eSpark-Consulting-Group/issamsmaali-powerbackupcircuit/Design-Files/PowerBackup-v2.1.1/Delievrables/Rendering/Isometric-02.png

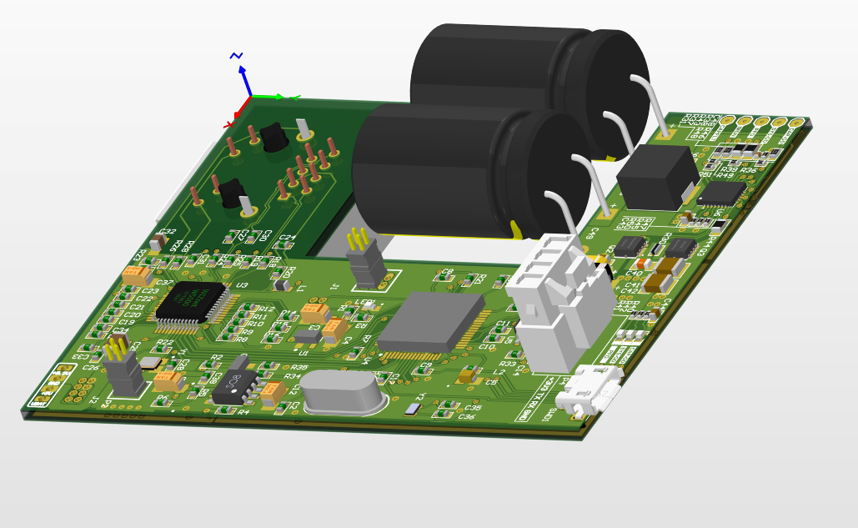
Design-Files/PowerBackup-v2.1.1/Delievrables/Rendering/Isometric-02.png
