eSpark-Consulting-Group/issamsmaali-powerbackupcircuit/Design-Files/PowerBackup-v2.1.1/Delievrables/Rendering/2D-View.png

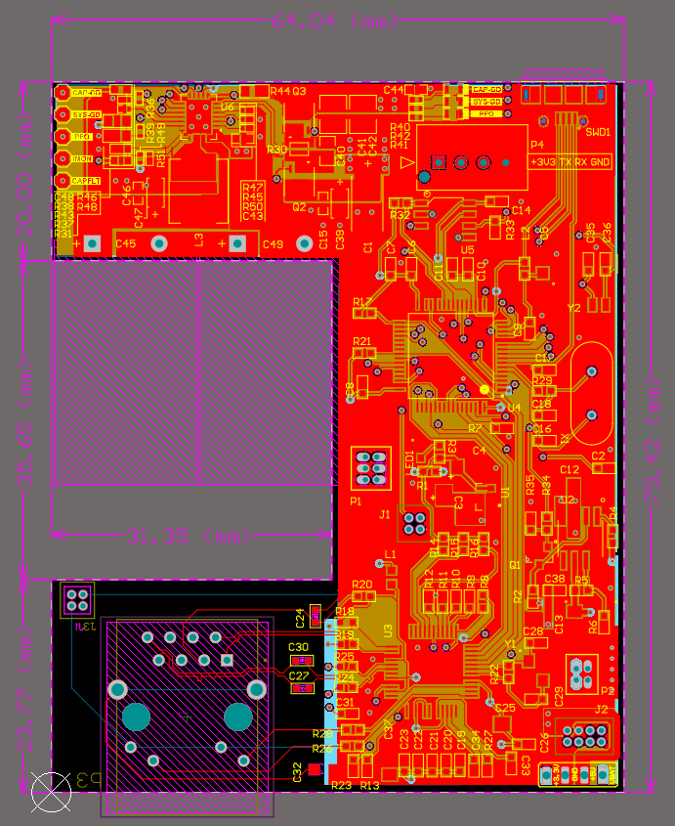
Design-Files/PowerBackup-v2.1.1/Delievrables/Rendering/2D-View.png
