eSpark-Consulting-Group/issamsmaali-powerbackupcircuit/Design-Files/PowerBackup-v2.1.1/Delievrables/Rendering/Isometric.png

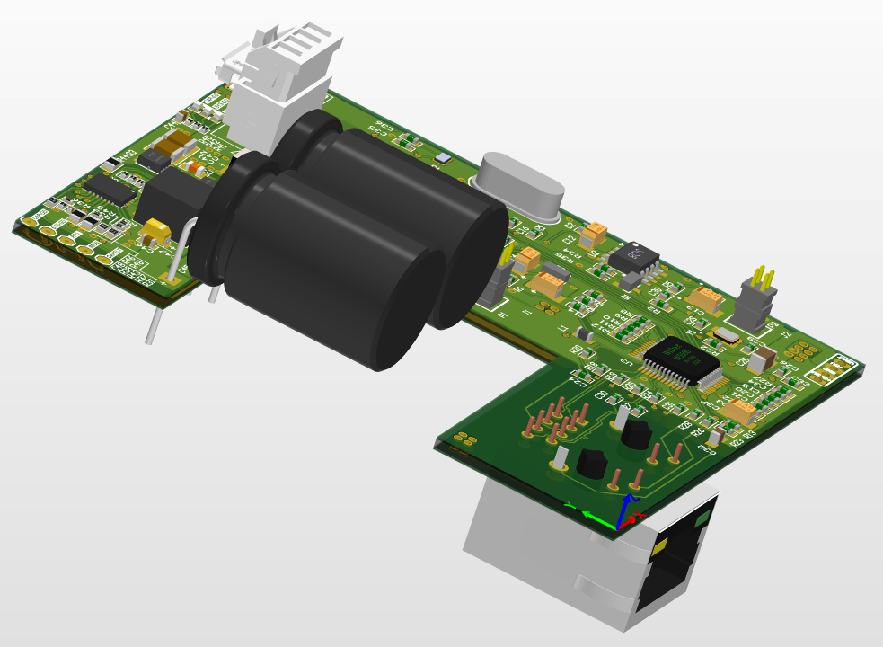
Design-Files/PowerBackup-v2.1.1/Delievrables/Rendering/Isometric.png
