eSpark-Consulting-Group/issamsmaali-powerbackupcircuit/Design-Files/PowerBackup-v2.1.1/BOM/Client_BOM.xlsx

# | Item Type | Designator | Description | Footprint | Manufacturer Part Number | Manufacturer | Comment | Quantity | Remarks
1 | Capacitors | C1 | CAP ALUM POLY 68UF 20% 50V SMD | 50SVPF68M | 50SVPF68M | Panasonic | 68uF | 1
2 | Capacitors | C2, C6, C7, C8, C9, C11, C14, C17, C19, C20, C21, C22, C23, C24 | CAPACITOR 0603 CERAMIC | 0603C-TBD | CL10F104ZO8NNNC | Samsung | 0.1uF/16V | 14
3 | Capacitors | C3, C4 | CAP TANT 10UF 10% 10V 1206 (3216) | C-3216(TANTAL) - INV | TAJA106K006RNJ | Kyocera AVX | 10uF/10V | 2
4 | Capacitors | C5 | Polarized Capacitor 1uF/16V TANTAL 0805 | C-2012 - TANT | F921C105MPA | Kyocera AVX | 1uF/6.3v | 1
5 | Capacitors | C10, C38 | Capacitor 1uF 6.3V X5R 10% SMD 0603 | 0603C-TBD | CL10A105KQ8NNNC | Samsung | 1uF/6.3v | 2
6 | Capacitors | C12, C13 | Tantalum Capacitors - Solid SMD 10V 22uF 20% 3216 -1206 | C-3216(TANTAL) | TAJA226M010RNJ | Kyocera AVX | 22uF/10V | 2
7 | Capacitors | C15, C43, C44, C46 | Multilayer Ceramic Capacitor, 0.1 uF, 16 V, -20, +80%, Y5V, 0603 [1608 Metric] | Cap-0603 | CL10F104ZO8NNNC | Samsung | 0.1uF | 4
8 | Capacitors | C16, C18 | Capacitor 20p 50v 0603 | 0603C-TBD | CL10C200JB8NNNC | Samsung | 20pF | 2
9 | Capacitors | C25, C37 | CAP TANT 10UF 10% 10V 1206 (3216) | C-3216(TANTAL) | TAJA106K010RNJ | Kyocera AVX | 10uF/10V | 2
10 | Capacitors | C26, C31, C34 | Multilayer Ceramic Capacitors MLCC - SMD/SMT 16V 0.01uF 0603 X8R 5% | C-1608 | C0603X103J4HACTU | KEMET | 10nF | 3
11 | Capacitors | C27, C30 | 6800pF ±10% 200V Ceramic Capacitor X7R 0603 (1608 Metric) | C-1608 | C0603C682K2RECAUTO | KEMET | 6.8.nF | 2
12 | Capacitors | C28, C29 | 18pF ±5% 50V Ceramic Capacitor C0G, NP0 0603 (1608 Metric) | C-1608 | CL10C180JB8NNNC | Samsung | 18pF | 2
13 | Capacitors | C32 | 1000pF ±10% 1000V (1kV) Ceramic Capacitor X7R 0805 (2012 Metric) | C-2012 | C0805C102KDRACAUTO | KEMET | 1nF/2kV | 1
14 | Capacitors | C33 | CAP CER 4,7UF 10V X5R 0603 | 0603C-TBD |  |  | 4.7uF | 1
15 | Capacitors | C35, C36 | CAPACITOR 0603 CERAMIC 9p 50V | 0603C-TBD | CGA3E2NP01H090D080AA | TDK | 9p | 2
16 | Capacitors | C39, C47 | CAP TANT 10UF 10% 10V 1206 | Case-A | TAJA106K010RNJ | Kyocera AVX | 10uF | 2
17 | Capacitors | C40 | CAP CER 2.2UF 16V X7R 0805 | Cap-0805 | EMK212B7225KGHT | Taiyo Yuden | 2.2uF | 1
18 | Capacitors | C41, C42 | CAP CER 100UF 16V X5R 1210 | Cap-1210 | EMK325ABJ107MM-P | Taiyo Yuden | 100uF | 2
19 | Capacitors | C45, C49 | CAPACITOR 25F -10%, +30% 2.7V TH | DGH256Q2R7 | DGH256Q2R7 | CDE Illinois Capacitor | 25F | 2
20 | Capacitors | C48 | CAP CER 1000PF 25V X7R 0402 | Cap-0402 | CC0402KRX7R8BB102 | Yageo | 1nF | 1
21 | Header | J1, J3 | Socket Strip, Cuttable, Double Row, 0.050"x0.050" Pitch | SFMC-102-X1-XX-D | SFMC-102-X1-XX-D | SAMTEC | - | 2
22 | Header | J2 | Socket Strip, Cuttable, Double Row, 0.050"x0.050" Pitch | SFMC-104-X1-XX-D | SFMC-104-X1-XX-D | SAMTEC | - | 1
23 | Inductor | L1 | FIXED IND 1.5UH 625MA 150 MOHM | L-1608 | GLFR1608T1R5M-LR | TDK | - | 1
24 | Inductor | L2 | FERRITE BEAD 30 OHM 0603 1LN | 0603C-TBD | MPZ1608S300ATAH0 | TDK | 30 OHM | 1
25 | Inductor | L3 | 9.5A 2.2uH ±20% 16A SMD,7.15x6.6x5mm Power Inductors ROHS | MS0650-2R2M-C | MS0650-2R2M-C | COILMX | 2.2uH | 1
26 | Inductor | LED1 | LED RED CLEAR 2SMD 1.95V, 5mA | LED-1608 | 19-217/R6C-AL1M2VY/3T | Everlight | POWER | 1
27 | LED | LED2, LED3 | yellow 0603 Light Emitting Diodes (LED) ROHS | LED-0603 | NCD0603Y2 | Foshan NationStar Optoelectronics | Yellow | 2
28 | LED | LED4 | RED LED 0603 Light Emitting Diodes | LED-0603 | NCD0603R3 | Foshan NationStar Optoelectronics | RED | 1
29 | Header | P1 | CONN HDR 6POS 0.05 STACK T/H Dual row | 3x2A 1.27 Double Samtec | FW-03-04-L-D-200-100 | Samtec | - | 1
30 | Header | P2 | CONN HDR 4POS 0.05 STACK T/H Dual row | 2x2A 1.27 Double Samtec | FW-02-04-L-D-200-100 | Samtec | - | 1
31 | Header | P3 | CONN MAGJACK 1PORT 100 BASE-T | WIZnet_RB1-125BAG1A_0 | RB1-125BAG1A | WIZnet | - | 1
32 | Header | P4 | Connector Header Through Hole 4 position 0.098" (2.50mm) | CON_2078430004_MOL | 207843-0004 | Molex | - | 1
33 | MOSFETs | Q1 | MOSFET N-CH 60V 115MA SOT23-3 | SOT23 |  |  | - | 1
34 | MOSFETs | Q2, Q3 | MOSFET N-CH 40V 40A PPAK1212-8 | PowerPAK® 1212-8 | SIS488DN-T1-GE3 | Vishay Semiconductors | - | 2
35 | Resistor | ~~R1~~ | ~~0 Ohms Jumper 0.1W, 1/10W Chip Resistor 0603 (1608 Metric) Moisture Resistant Thick Film~~ | ~~R-1608~~ | ~~RC0603JR-070RL~~ | ~~Yageo~~ | ~~0R~~ | ~~1~~ | ~~DNP~~
36 | Resistor | R2 | RES SMD 22K OHM 0.5% 1/16W 0603 | 0603C-TBD | RR0816P-223-D | Susumu | 22K | 1
37 | Resistor | R3 | Gen Purp Chip, R0603 0.1W 5% | 0603C-TBD | CRGCQ0603J330R | TE Connectivity | 330R | 1
38 | Resistor | R4, R6, R32, R33 | RES SMD 100K OHM 1% 1/4W 0603 | 0603C-TBD | RCA0603100KFKEAHP | Vishay Dale | 100K | 4
39 | Resistor | R5 | RES SMD 715K OHM 1% 1/10W 0603 | 0603C-TBD | RC0603FR-07402KL | Yageo | 402K | 1
40 | Resistor | R7, R8, R9, R10, R11, R12, R13, R14, R15, R16, R17, R21, R27 | RES SMD 10K OHM 0.5% 1/16W 0603 | 0603C-TBD | RR0816P-103-D | Susumu | 10K | 13
41 | Resistor | R18, R19, R24, R25 | RES SMD 49.9 OHM 1% 1/10W 0603 | R-1608 | RC0603FR-0749R9L | Yageo | 49R9 1% | 4
42 | Resistor | R20 | RES SMD 10 OHM 1% 1/10W 0603 | R-1608 | RC0603FR-0710RL | Yageo | 10R 1% | 1
43 | Resistor | R22 | Resistor CRGCQ 0603 1M0 5% | R-1608 | CRGCQ0603J1M0 | TE Connectivity | 1M | 1
44 | Resistor | R23 | RESISTOR 0603 12.4K 1% | R-1608 |  |  | 12.4K 1% | 1
45 | Resistor | R26, R28 | 330 Ohms ±5% 0.1W, 1/10W Chip Resistor 0603 | R-1608 | CRGCQ0603J330R | TE Connectivity | 330R | 2
46 | Resistor | R29 | 220 Ohms ±1% 0.1W, 1/10W Chip Resistor 0603 (1608 Metric) Moisture Resistant Thick Film | 0603C-TBD | RC0603FR-07220RL | Yageo | 220 | 1
47 | Resistor | R30 | Current Sense Resistors - SMD 1/3W 0.01ohm 1% | RES-0306 | PRL0816-R010-F-T1 | Susumu | 10mR | 1
48 | Resistor | R31 | RES SMD 113K OHM 0.1% 1/10W 0603 | Res-0603 | RT0603BRE07113KL | Yageo | 113K | 1
49 | Resistor | R34 | RES 100 OHM 5% 1/10W 0603 | 0603C-TBD | RMCF0603JT100R | Stackpole Electronics | 100R | 1
50 | Resistor | R35 | RES 4.7K OHM 5% 1/10W 0603 | 0603C-TBD | RMCF0603JT4K70 | Stackpole Electronics | 4K7 | 1
51 | Resistor | R36 | RES 6.2K OHM 1% 1/16W 0402 | Res-0402 | RC0402FR-076K2L | Yageo | 6.2K | 1
52 | Resistor | R37 | RES SMD 38.3KOHM 0.1% 1/10W 0603 | Res-0603 | RT0603BRD0738K3L | Yageo | 38.3K | 1
53 | Resistor | R38, R44 | RES 1.05 MOHM 1% 1/8W 0805 | RES-0805 | AC0805FR-071M05L | Yageo | 1.05MR | 2
54 | Resistor | R39, R45, R47, R49 | RES 0 OHM JUMPER 1/16W 0402 | Res-0402 | RC0402FR-070RL | Yageo | 0R | 4
55 | Resistor | R40, R41, R42 | RES 1.5K OHM 1% 1/16W 0402 | Res-0402 | RC0402FR-071K5L | Yageo | 1.5K | 3
56 | Resistor | R43 | RES SMD 200K OHM 0.1% 1/8W 0805 | RES-0805 | RT0805BRD07200KL | Yageo | 200K | 1
57 | Resistor | R46 | RES SMD 1.5M Ohm 1% 0.1W(1/10W) 0603 | Res-0603 | RC0603FR-071M5L | Yageo | 1M5 | 1
58 | Resistor | R48 | RES 261K OHM 1% 1/16W 0402 | Res-0402 | RC0402FR-07261KL | Yageo | 261K | 1
59 | Resistor | R50 | RES 2.49K OHM 1% 1/16W 0402 | Res-0402 | RC0402FR-072K49L | Yageo | 2.49K | 1
60 | Resistor | ~~R51~~ | ~~RES 0 OHM JUMPER 1/16W 0402~~ | ~~Res-0402~~ | ~~RC0402FR-070RL~~ | ~~Yageo~~ | ~~DNP~~ | ~~1~~ | ~~DNP~~
61 | USB | SWD1 | CONN RCPT MICRO USB AB R/A SMD | MOLEX_0475890001 | 47589-0001 | Molex | - | 1
62 | IC | U1 | Voltage Regulator; LDO; SOT-23; PD 369.6mW; VO 3.3V; Regline +/-0.75%/V | SOT23 | MCP1700T-3302E/TT | Microchip | - | 1
63 | IC | U2 | High performance 2A ULDO linear regulator | SOIC127P600X175-8N | RT9025-25GSP | Richtek | - | 1
64 | IC | U3 | Ethernet Controller 10/100 Base-T/TX PHY SPI Interface | W5500 | W5500 | WIZnet | - | 1
65 | IC | U4 | IC MCU 32BIT 512KB FLASH 64LQFP | STM-LQFP64_V | STM32L151RET6 | STMicroelectronics | - | 1
66 | IC | U5 | EEPROM Memory IC 2Mb _256K x 8_ SPI 5MHz 8-SO | SOIC8-1.27-5X4MM | M95M02-DWMN3TP/K | STMicroelectronics | - | 1
67 | IC | U6 | IC BATT PWR MGMT MULTI 1C 24QFN | 24-QFN (4x5) | LTC4041EUFD#PBF | Analog Devices / Linear Technology | - | 1
68 | Crystal | X1 | 8MHz ±30ppm Crystal 20pF 80 Ohms HC-49/US | XTAL_HC49P488W43L1150T466H350 | FC4STCBMF8.0-BAG200 | Fox Electronics | 8MHz | 1
69 | Crystal | Y1 | CRYSTAL 25.0000MHZ 8PF SMD | XTAL3225 | CX3225CA25000D0HSSCC | Kyocera AVX | 25MHz | 1
70 | Crystal | Y2 | ABS25 Series 32.768 kHz Â±20 ppm 6 pF -40 to +85 Â°C SMT Low Frequency Crystal | XTAL_CM8V-T1A-32.768KHZ-9PF-20PPM-TA-QC | CM8V-T1A 32.768kHz 9pF +/-20ppm TA QC | Micro Crystal | - | 1
