eSpark-Consulting-Group/issamsmaali-powerbackupcircuit/Design-Files/PowerBackup-v2.1.1/Delievrables/Supporting Files/Board3ph.step

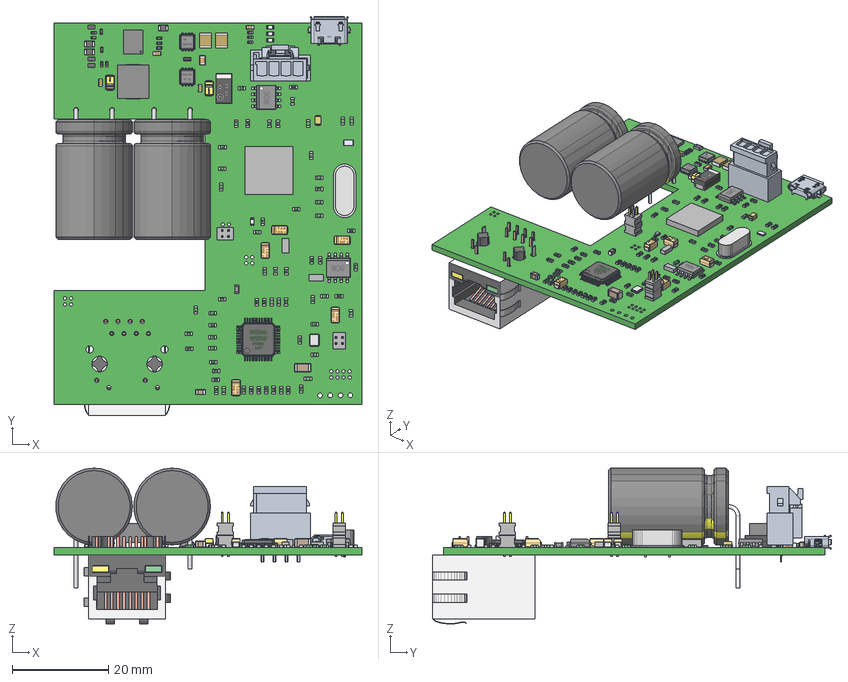
[picture p6: CAD file, 2025-02-18]
Design-Files/PowerBackup-v2.1.1/Delievrables/Supporting Files/Board3ph.step
64.1 x 83.1 x 32.4 mm
Extruded x 562
C-CASE
term1
term2
eBom-FreeParts x 2
DGH206Q2R009.dwg x 2
BAR x 2
KEMET x 2
User Library-CAPC1608X09 x 4
LTC4041EUFD_PBF
User Library-CR2012-0805 x 3
User Library-RES_1005-0402 x 11
User Library-RESC1608X05N x 3
PowerPAK 1212-8 x 2
User Library-LED SMD0603 x 3
MS0650-2R2M-C
User Library-Capacitor 0402
User Library-CAPC3225X10 x 2
User Library-0805 SMD Capacitor
User Library-SOIC8_JEDEC_MS-012AA x 2
INDC1608X100N
SW3dPS-LED SMD0603
User Library-CAP_TAN_C3216_1206 x 5
User Library-HC49S_Extruded3
User Library-HC49S_Cylinder1 x 2
User Library-HC49S_Extruded2
FilletPin1
FilletPin2
CAPC3216X180N
CAPC2012X110N
_FW-02-02-F-D-200-090_bottom_body x 2
_FW-02-02-F-D-200-090_pins1 x 2
_FW-02-02-F-D-200-200_pins2 x 2
_FW-02-02-F-D-200-090_top_body x 2
User Library-J1B1211CCD
User Library-WIZNET_W5500
User Library-Crystal NDK NX2520SA series
