eSpark-Consulting-Group/issamsmaali-powerbackupcircuit/(list of files, cad)

Other CAD files:
Design-Files/PowerBackup-v2.1.1/Delievrables/Supporting Files/Board3ph.DWG
Design-Files/PowerBackup-v2.1.1/Delievrables/Supporting Files/Board3ph.DXF
