eSpark-Consulting-Group/issamsmaali-powerbackupcircuit/Design-Files/PowerBackup-v2.1.1/PowerBackup-v2.1.1.pdf

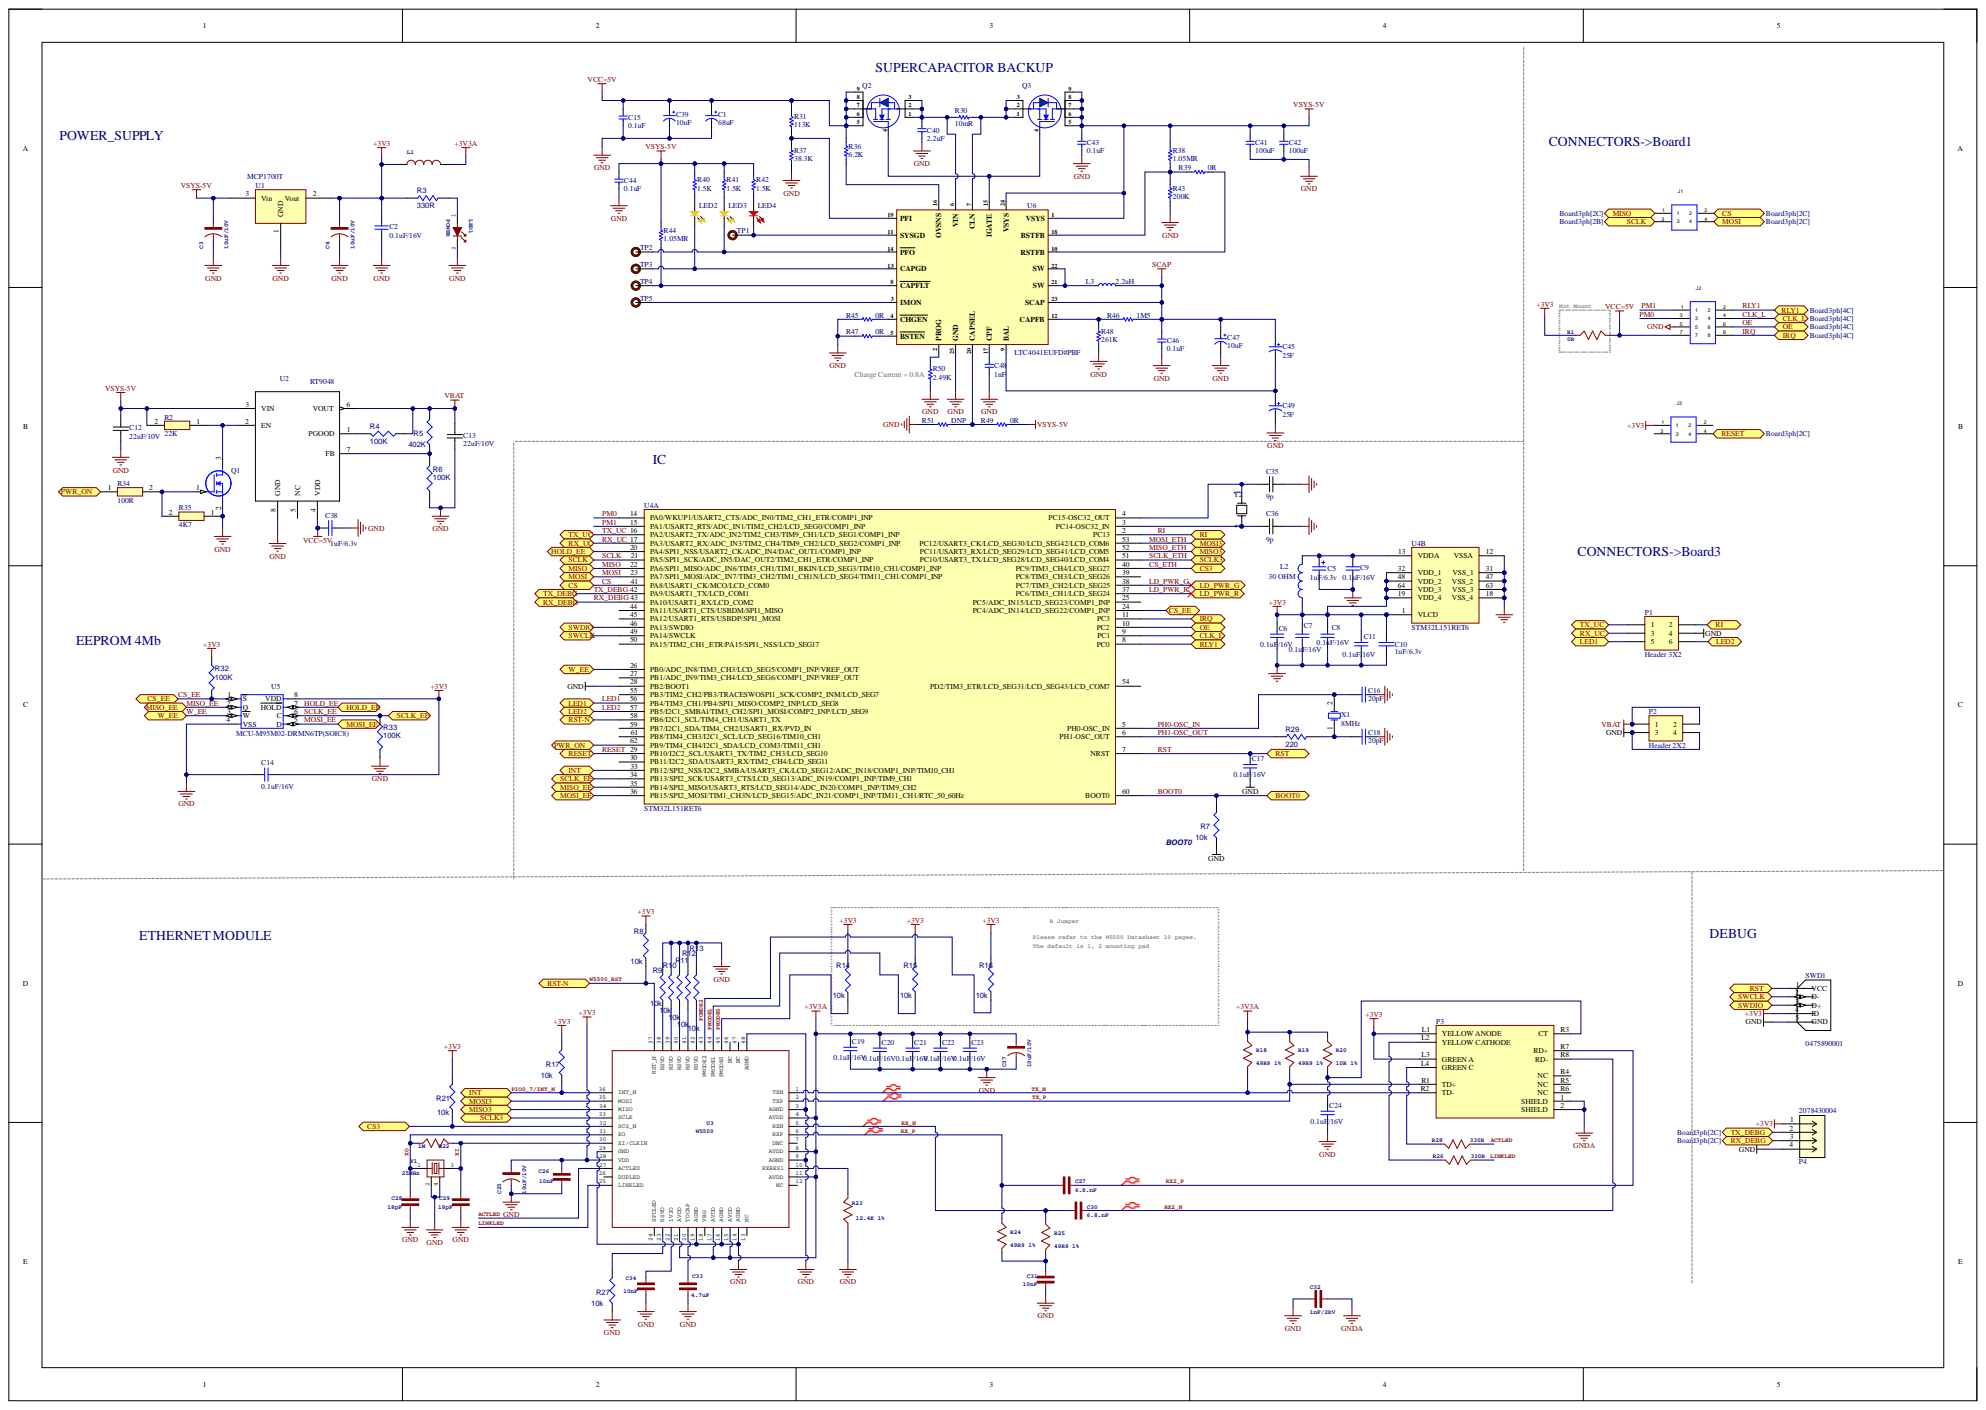
[picture p7: page 1]

GND

Please refer to the W5500 Datasheet 10 pages.
The default is 1, 2 mounting pad

NC 13 AGND 14 AVDD 15 AGND 16 AVDD 17 VBG 18 AGND 19 TOCAP 20 AVDD 21 1V2O 22 RSVD 23 SPDLED 24

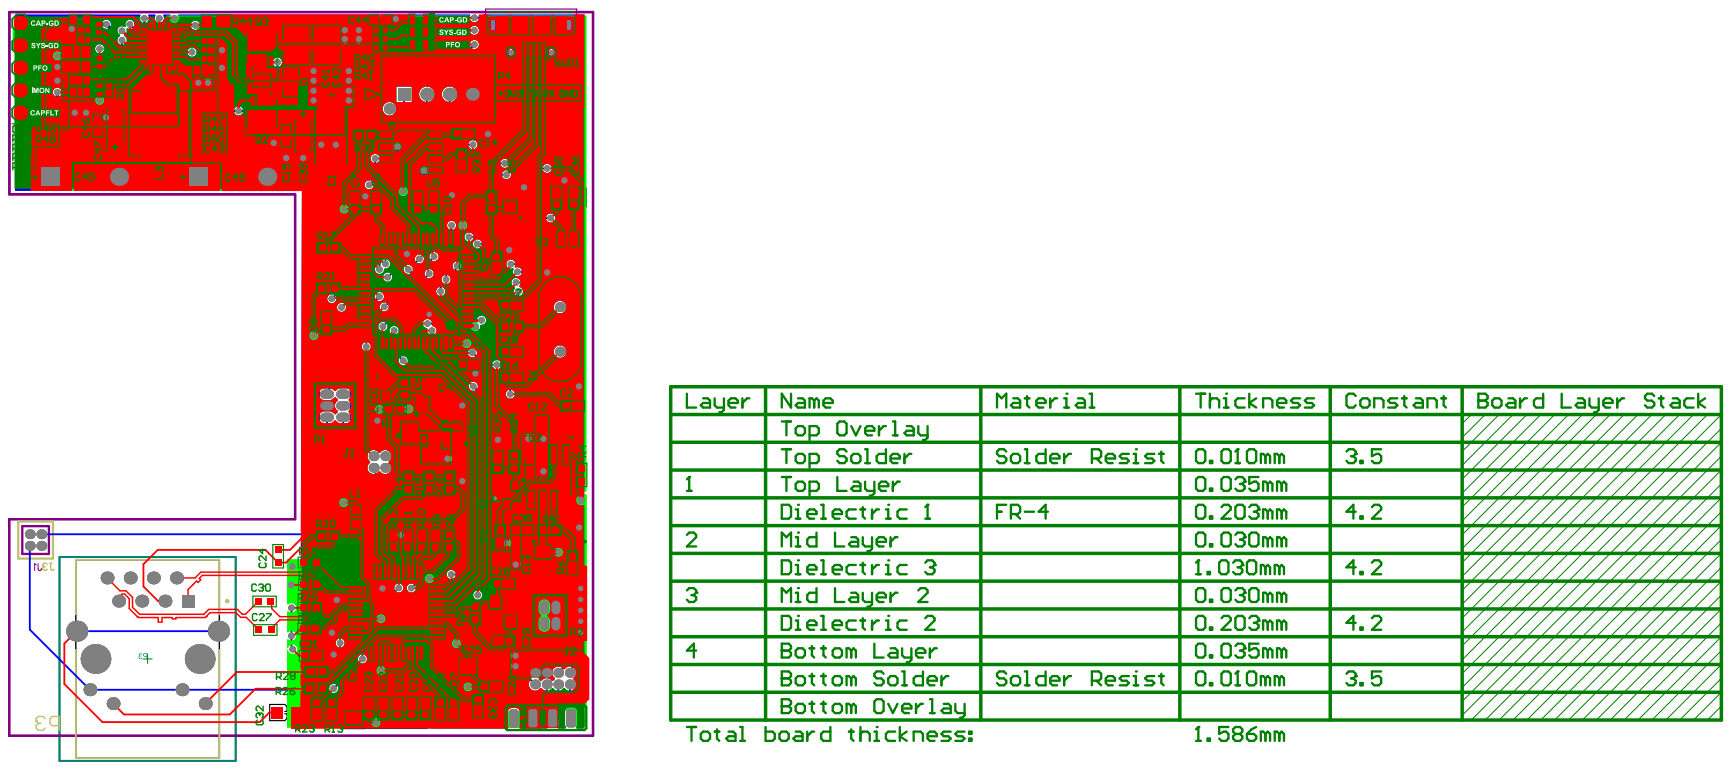
[picture p8: page 2]
