eSpark-Consulting-Group/issamsmaali-powerbackupcircuit/Design-Files/PowerBackup-v2.1.1/Delievrables/Schematics/Assmebly Drawing.pdf

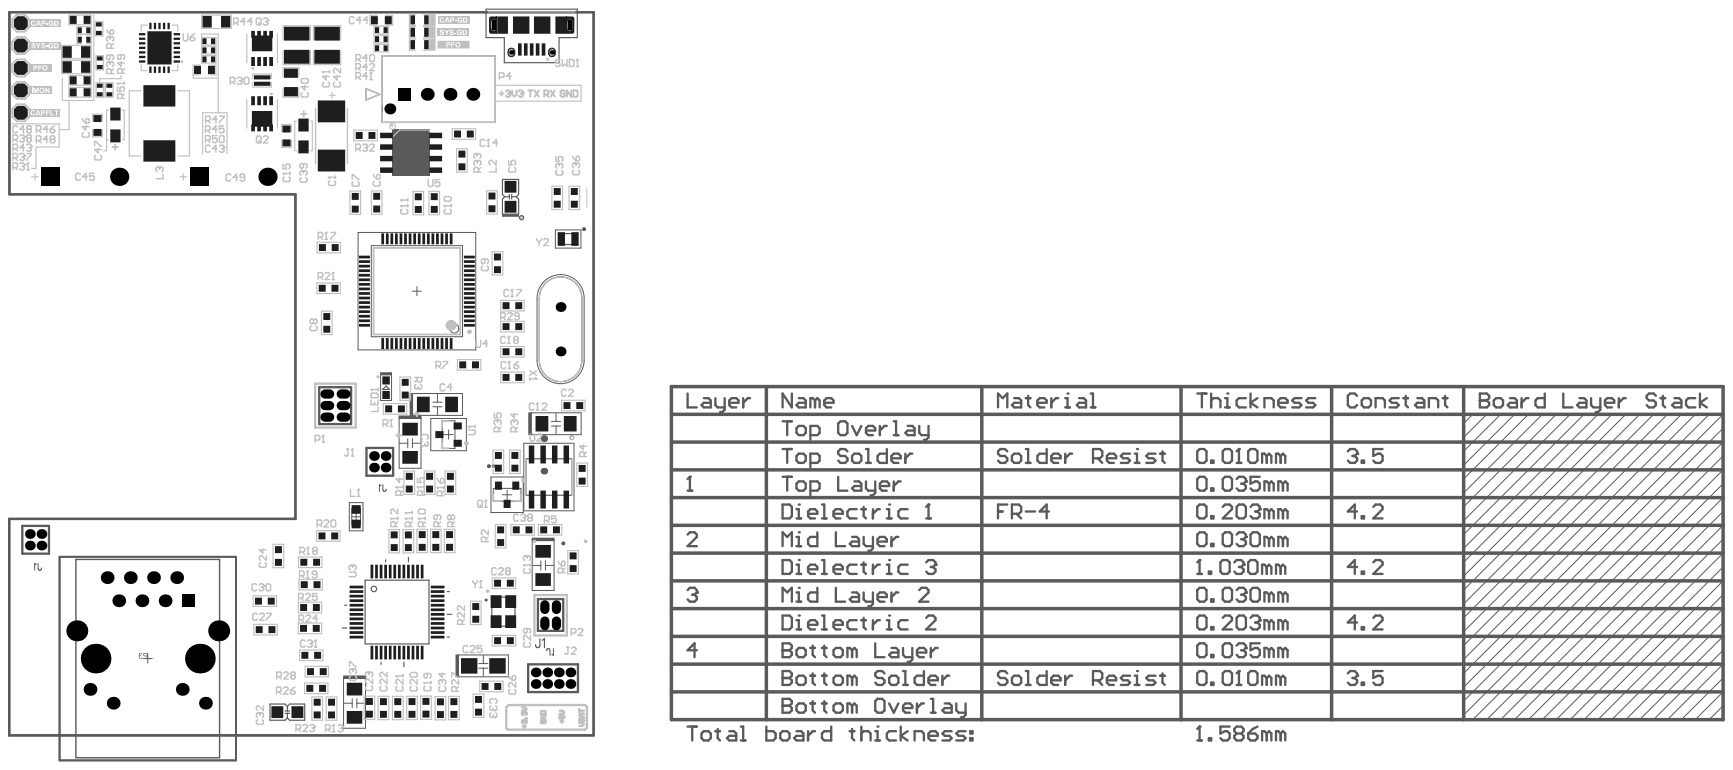
[picture p9: page 1]

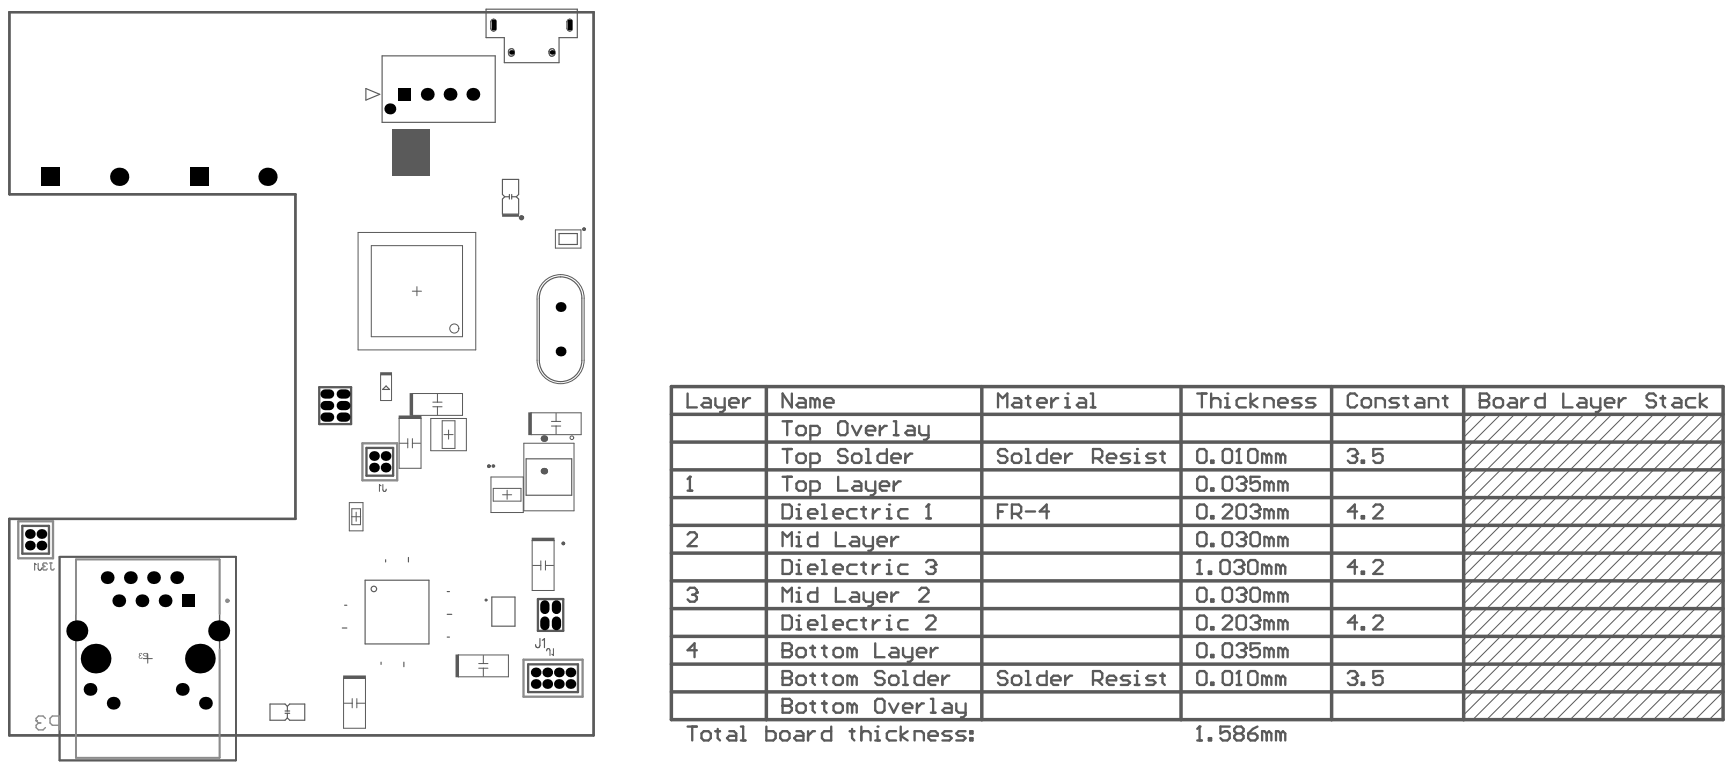
[picture p10: page 2]
