eSpark-Consulting-Group/issamsmaali-powerbackupcircuit/(list of files, drawings)

Other design files:
Design Files/Design-v2.1.0/PowerBackup-v2.1.0/PowerBackup-v2.1.0.PrjPcb
Design-Files/PowerBackup-v2.1.1/Board3ph.PcbDoc
Design-Files/PowerBackup-v2.1.1/Board3ph.SchDoc
Design-Files/PowerBackup-v2.1.1/PowerBackup-v2.1.1.PrjPcb
docs/Client-Files/Board3ph.SchDoc
