eSpark-Consulting-Group/issamsmaali-powerbackupcircuit/(commit log)

2024-12-03 #1 Schematic in Process.
    [Powerbackup-PCB-v2.PcbDoc, Powerbackupcircuit-v2.PrjPcb, Sheet1.SchDoc, Sheet2.SchDoc, Sheet3.SchDoc]
2024-12-04 #1 Schematic Updated.
    [Connector-Section.SchDoc, Controller-Section.SchDoc, Ethernet-Section.SchDoc, Power-Section.SchDoc, Powerbackupcircuit-v2.PrjPcb, Sheet1.SchDoc, Sheet2.SchDoc, Sheet3.SchDoc]
2024-12-09 #1 Supercapacitor circuitry added. MAX38888 added.
    [Board3ph.PcbDoc, Board3ph.SchDoc, Connector-Section.SchDoc, Controller-Section.SchDoc, Ethernet-Section.SchDoc, Power-Section.SchDoc, Powerbackup-PCB-v2.PcbDoc, Powerbackupcircuit-v2.PrjPcb]
2024-12-10 #1 LTC4041 IC added and now 5V is also on backup
    [Board3ph.SchDoc]
2024-12-10 #1 Missing annotations added.
    [Board3ph.SchDoc]
2024-12-23 #1 Files linked to project... 2 capacitors scheme added.
    [Board3ph.PcbDoc, Board3ph.SchDoc, PowerBackup-v2.0.PrjPcb]
2024-12-24 Extra files removed
    [Connector-Section.SchDoc, Controller-Section.SchDoc, Ethernet-Section.SchDoc, Power-Section.SchDoc, Powerbackup-PCB-v2.PcbDoc, Powerbackupcircuit-v2.PrjPcb]
2024-12-24 Update: Versioning according to tag
    [Board3ph.PcbDoc, Board3ph.SchDoc, PowerBackup-v2.1.0.PrjPcb]
2024-12-27 #1 Added NM resistor and changed version number to v2.1.1
    [Board3ph.PcbDoc, Board3ph.SchDoc, PowerBackup-v2.1.1.PrjPcb]
2025-01-07 #2 Placement in Progress
    [Board3ph.PcbDoc]
2025-01-08 #2 Caps added due to footprint missing issue, Routing in progress
    [Board3ph.PcbDoc, Board3ph.SchDoc, PowerBackup-v2.1.1.PrjPcb]
2025-01-09 #2 Completed and Deliverables generated
    [Board3ph.DWG, Board3ph.DXF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]
2025-01-10 #3 #2 Changes done, review completed.
    [Board3ph.PcbDoc]
2025-01-10 @basit-eSpark R1 DNP kr dia ha BOM me.
    [Client_BOM.xlsx]
2025-01-10 #3 #2 Deliverables generated
    [Board3ph.DWG, Board3ph.DXF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]
2025-01-10 Folder restructuring
    [Board3ph.DWG, Board3ph.DXF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]
2025-02-18 #3 Components moved to top side. Deliverables generated
    [Board3ph.DWG, Board3ph.DXF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]
